henry781/floppy-revival/hardware/fabrication/bom.csv

Reference | Value | QUANTITY | Description | Footprint
A1 | RaspberryPi_Pico2 | 1 | Raspberry Pi Pico 2 (RP2350), soldered flat by its castellations | Module:RaspberryPi_Pico_Common_SMD
C1 | 100nF | 1 | 100nF X7R ceramic, 2.5 mm, Murata RCER71H104K0DBH03A; at U1 VCC (pin 14) | Capacitor_THT:C_Disc_D3.0mm_W1.6mm_P2.50mm
C2 | 100nF | 1 | 100nF X7R ceramic, 2.5 mm, Murata RCER71H104K0DBH03A; at U2 VCC (pin 14) | Capacitor_THT:C_Disc_D3.0mm_W1.6mm_P2.50mm
C3 | 100nF | 1 | 100nF X7R ceramic, 2.5 mm, Murata RCER71H104K0DBH03A; at the Pico 3V3(OUT) | Capacitor_THT:C_Disc_D3.0mm_W1.6mm_P2.50mm
C4 | 47µF | 1 | 47uF 25V electrolytic, Panasonic FR EEUFR1E470 (D5x11, P2.0); 3.3V rail (polarized: pad 1 = +) | Capacitor_THT:CP_Radial_D5.0mm_P2.00mm
C5 | 47µF | 1 | 47uF 25V electrolytic, Panasonic FR EEUFR1E470 (D5x11, P2.0); VBUS at the Pico (polarized: pad 1 = +), total VBUS capacitance kept under ~100uF | Capacitor_THT:CP_Radial_D5.0mm_P2.00mm
C6 | 220uF 25V | 1 | post-filter cap, Panasonic FR EEUFR1E221 (D8x11.5, 3.5mm), at the drive terminal | Capacitor_THT:CP_Radial_D8.0mm_P3.50mm
C7 | 220uF 16V | 1 | post-filter cap, Panasonic FR EEUFR1C221 (D6.3x11.2, 2.5mm), at the drive terminal | Capacitor_THT:CP_Radial_D6.3mm_P2.50mm
C8 | 100uF 35V | 1 | 100uF 35V low-ESR 105C electrolytic, Panasonic FC EEUFC1V101 (D8x11.5, P3.5); switched-node bulk, first cap of the input pi filter | Capacitor_THT:CP_Radial_D8.0mm_P3.50mm
C9,C10 | 100nF | 2 | rail HF decoupling at J5; Murata RDER71H104K0K1H03B (5 mm pitch) | Capacitor_THT:C_Disc_D5.1mm_W3.2mm_P5.00mm
C11 | 10uF 50V | 1 | Q1 gate-source, TDK FG20X7R1H106KRT06 (10uF 50V X7R, 5 mm): ~10 x C22 so an adapter hot-plug cannot couple Q1 on through C22 | Capacitor_THT:C_Disc_D6.0mm_W4.4mm_P5.00mm
C12,C16 | 470uF 35V | 2 | buck input bulk, Panasonic FR EEUFR1V471L (D8x20, 3.5mm, 1.56A ripple), right at VIN/GND | Capacitor_THT:CP_Radial_D8.0mm_P3.50mm
C13,C17 | 1uF 50V | 2 | X7R high-frequency input bypass, closest to VIN pin 2; Murata RDER71H105K2K1H03B | Capacitor_THT:C_Disc_D5.1mm_W3.2mm_P5.00mm
C14,C18 | 10nF 50V | 2 | bootstrap capacitor CB-SW (datasheet: 0.01 uF); Murata RDER71H103K0K1H03B (5 mm pitch) | Capacitor_THT:C_Disc_D5.1mm_W3.2mm_P5.00mm
C15 | 470uF 35V | 1 | buck output cap, Panasonic FR EEUFR1V471L (D8x20, 3.5mm, 30mOhm, same part as the input caps); ESR sets loop stability (datasheet 7.1.3) | Capacitor_THT:CP_Radial_D8.0mm_P3.50mm
C19 | 470uF 16V | 1 | buck output cap, Panasonic FR EEUFR1C471 (D8x11.5, 3.5mm, 56mOhm); ESR sets loop stability (datasheet 7.1.3) | Capacitor_THT:CP_Radial_D8.0mm_P3.50mm
C20 | 470pF 100V | 1 | SW snubber capacitor 470pF 100V C0G, Murata RDE5C2A471J0M1H03A (5 mm pitch), REQUIRED (with R27) | Capacitor_THT:C_Disc_D5.1mm_W3.2mm_P5.00mm
C21 | 470pF 100V | 1 | SW snubber capacitor 470pF 100V C0G, Murata RDE5C2A471J0M1H03A (5 mm pitch), REQUIRED (with R28) | Capacitor_THT:C_Disc_D5.1mm_W3.2mm_P5.00mm
C22 | 1uF 50V | 1 | Q1 Miller capacitor gate-drain, Murata RDER71H105K2K1H03B (1uF 50V X7R, 5 mm): dV/dt ~1 V/ms, adapter peak ~1.9A into the ~1 mF behind Q1 (simulated) | Capacitor_THT:C_Disc_D5.1mm_W3.2mm_P5.00mm
C23 | 10nF 50V | 1 | DRV_EN filter at the ON/OFF pins, Murata RDER71H103K0K1H03B (5 mm pitch) | Capacitor_THT:C_Disc_D5.1mm_W3.2mm_P5.00mm
C24 | 100nF | 1 | adapter sense filter at GP26 (tau 3.5 ms with R31||R32); Murata RDER71H104K0K1H03B (5 mm pitch) | Capacitor_THT:C_Disc_D5.1mm_W3.2mm_P5.00mm
D1 | LED | 1 | LED 3 mm green (ACT), horizontal mount | LED_THT:LED_D3.0mm_Horizontal_O6.35mm_Z6.0mm
D2 | LED | 1 | LED 3 mm red (DIRTY), horizontal mount | LED_THT:LED_D3.0mm_Horizontal_O6.35mm_Z6.0mm
D3 | P6KE27A | 1 | TVS Littelfuse P6KE27A (standoff 23.1V: margin for 20V adapters), input surge clamp | Diode_THT:D_DO-15_P10.16mm_Horizontal
D4 | P6KE15A | 1 | 12V rail TVS, Littelfuse P6KE15A: a shorted regulator switch would put 19.5V on the drive | Diode_THT:D_DO-15_P10.16mm_Horizontal
D5 | P6KE6.8A | 1 | 5V rail TVS, Littelfuse P6KE6.8A: a shorted regulator switch would put 19.5V on the drive logic | Diode_THT:D_DO-15_P10.16mm_Horizontal
D6,D7 | SB560 | 2 | catch diode, Vishay SB560-E3/54 (60V 5A Schottky): simulated reverse peak <= 35V with the snubber | Diode_THT:D_DO-201AD_P5.08mm_Vertical_AnodeUp
F1 | MF-R300 3A 30V | 1 | Resettable PTC fuse, 3A hold / 6A trip, 30V max (MF-RG is only 16V!) | FloppyRevival:PTC_Radial_P5.08mm
J1 | Conn_02x17_Odd_Even | 1 | 34-pin (2x17) box header, 2.54 mm, vertical, keyed | Connector_IDC:IDC-Header_2x17_P2.54mm_Vertical
J2 | Conn_01x03 | 1 | 1x3 pin header 2.54 mm (UART: GND, TX, RX) | Connector_PinHeader_2.54mm:PinHeader_1x03_P2.54mm_Vertical
J3 | Conn_01x02 | 1 | 1x2 pin header 2.54 mm + jumper (read-only) | Connector_PinHeader_2.54mm:PinHeader_1x02_P2.54mm_Vertical
J4 | 19V5 IN | 1 | Phoenix Contact MKDS 1,5/2-5,08 (1715721), 19.5V DC input (pin 1 = +, pin 2 = GND) | TerminalBlock_Phoenix:TerminalBlock_Phoenix_MKDS-1,5-2-5.08_1x02_P5.08mm_Horizontal
J5 | DRIVE PWR | 1 | Phoenix Contact MKDS 1,5/4-5,08 (1715747) to the drive Molex: 1=+12V 2=GND 3=GND 4=+5V | TerminalBlock_Phoenix:TerminalBlock_Phoenix_MKDS-1,5-4-5.08_1x04_P5.08mm_Horizontal
L1,L3 | 33uH 6A | 2 | buck inductor, Feryster DTMSS-16/0.033/6.0-V sendust toroid (33uH at 0A, 23uH at 6A, 24.5mOhm) | FloppyRevival:L_Toroid_Vertical_D22.0mm_W11.0mm_P9.00mm
L2,L4 | 4.7uH 5A | 2 | post-filter inductor, Ferrocore COIL0608-0.0047 (4.7uH, Isat 5A, 22.9mOhm) | FloppyRevival:L_Radial_D7.5mm_P3.00mm
L5 | 4.7uH 5A | 1 | input filter inductor, Ferrocore COIL0608-0.0047: with C8 and the bulk caps a pi filter keeping the 260 kHz input current off the adapter cable (Z0 ~0.07 ohm << converter input ~16 ohm, no Middlebrook issue) | FloppyRevival:L_Radial_D7.5mm_P3.00mm
Q1 | IRF9540N | 1 | P-MOSFET high-side switch, Infineon IRF9540NPBF (-100V, 23A, TO-220 G-D-S) | Package_TO_SOT_THT:TO-220-3_Vertical
Q2 | BC547 | 1 | NPN level shifter GP18 -> Q1 gate, BC547B (TO-92 C-B-E, outer legs bent to 2.54 mm) | Package_TO_SOT_THT:TO-92_Inline_Wide
R9-R13,R19,R20 | 330 | 7 | metal film 0.25W 1%, axial | Resistor_THT:R_Axial_DIN0207_L6.3mm_D2.5mm_P10.16mm_Horizontal
R14 | 1K | 1 | metal film 0.25W 1%, axial | Resistor_THT:R_Axial_DIN0207_L6.3mm_D2.5mm_P10.16mm_Horizontal
R22 | 10k | 1 | Q2 base series resistor; metal film 0.25W 1%, axial | Resistor_THT:R_Axial_DIN0207_L6.3mm_D2.5mm_P10.16mm_Horizontal
R23 | 100k | 1 | Q2 base pull-down: drive power stays OFF while GP18 floats (reset/boot/BOOTSEL); metal film 0.25W 1%, axial | Resistor_THT:R_Axial_DIN0207_L6.3mm_D2.5mm_P10.16mm_Horizontal
R24 | 47k | 1 | Q1 gate-source pull-up (switch OFF by default); metal film 0.25W 1%, axial | Resistor_THT:R_Axial_DIN0207_L6.3mm_D2.5mm_P10.16mm_Horizontal
R25 | 22k | 1 | Q1 gate divider: Vgs = -19.5V x 47/(47+22) = -13V (|Vgs| < 20V max); metal film 0.25W 1%, axial | Resistor_THT:R_Axial_DIN0207_L6.3mm_D2.5mm_P10.16mm_Horizontal
R26 | 2k2 | 1 | Bleed on the switched 19.5V node, Vishay MRS25 2k2 0.6W (173 mW): the ~1 mF behind Q1 is below the regulators' 7.9V lockout 2.6 s after GP18 drops (simulated), inside the firmware's 3.5 s hold | Resistor_THT:R_Axial_DIN0207_L6.3mm_D2.5mm_P10.16mm_Horizontal
R27,R28 | 10R | 2 | SW snubber resistor 10R 1/4W (~25 mW), REQUIRED: without it the catch diode sees up to 40V (simulated) | Resistor_THT:R_Axial_DIN0207_L6.3mm_D2.5mm_P10.16mm_Horizontal
R29 | 1k | 1 | GP18 -> regulator ON/OFF pins (DRV_EN); metal film 0.25W 1%, axial | Resistor_THT:R_Axial_DIN0207_L6.3mm_D2.5mm_P10.16mm_Horizontal
R30 | 4k7 | 1 | DRV_EN pull-down: < 0.43V against the 2 x 45uA ON/OFF pull-ups while GP18 floats; metal film 0.25W 1%, axial | Resistor_THT:R_Axial_DIN0207_L6.3mm_D2.5mm_P10.16mm_Horizontal
R31 | 330k | 1 | adapter sense divider top, 19V5_F -> GP26; metal film 0.25W 1%, axial (57 uA into an unpowered Pico pad) | Resistor_THT:R_Axial_DIN0207_L6.3mm_D2.5mm_P7.62mm_Horizontal
R32 | 39k | 1 | adapter sense divider bottom (ratio 9.46 with R31); metal film 0.25W 1%, axial | Resistor_THT:R_Axial_DIN0207_L6.3mm_D2.5mm_P7.62mm_Horizontal
R33 | 470R | 1 | 5V minimum-load bleeder (10.6 mA, 53 mW): without it U4 leakage lifts the unloaded 5V rail to ~6.1V (bench 2026-11-03) | Resistor_THT:R_Axial_DIN0207_L6.3mm_D2.5mm_P10.16mm_Horizontal
RN1 | 10k x9 | 1 | 10k pull-ups to 3V3 on GP2..GP9, bussed SIP10, Bourns 4610X-101-103LF (pin 1 common) | Resistor_THT:R_Array_SIP10
RN2 | 10k x4 | 1 | 10k pull-ups to 3V3 on GP13..GP10 (7407 inputs), bussed SIP5, Bourns 4605X-101-103LF | Resistor_THT:R_Array_SIP5
RN3 | 1k x4 | 1 | 1k pull-ups to 3V3 on the drive outputs (drive side of the 330s), bussed SIP5, Bourns 4605X-101-102LF | Resistor_THT:R_Array_SIP5
TP1 | WGATE | 1 | test point | TestPoint:TestPoint_THTPad_D2.0mm_Drill1.0mm
TP2 | MOTOR | 1 | test point | TestPoint:TestPoint_THTPad_D2.0mm_Drill1.0mm
TP3 | RDATA | 1 | test point | TestPoint:TestPoint_THTPad_D2.0mm_Drill1.0mm
TP4 | INDEX | 1 | test point | TestPoint:TestPoint_THTPad_D2.0mm_Drill1.0mm
TP5 | +3.3V | 1 | test point | TestPoint:TestPoint_THTPad_D2.0mm_Drill1.0mm
TP6 | VBUS | 1 | test point | TestPoint:TestPoint_THTPad_D2.0mm_Drill1.0mm
TP7,TP8 | GND | 2 | test point | TestPoint:TestPoint_THTPad_D2.0mm_Drill1.0mm
TP9 | RUN | 1 | test point | TestPoint:TestPoint_THTPad_D2.0mm_Drill1.0mm
U1,U2 | 7407 | 2 | TI SN7407N hex open-collector buffer (DIP-14) in a DIP-14 socket, 7.62 mm; outputs STEP, MOTOR, DS1, REDWC, DIR. Non-inverting ONLY (never 7406/74LS06) | Package_DIP:DIP-14_W7.62mm
U1 | 7407 | 1 | TI SN7407N hex open-collector buffer (DIP-14) in a DIP-14 socket, 7.62 mm; outputs SIDE1, WGATE, WDATA. Non-inverting ONLY (never 7406/74LS06) | Package_DIP:DIP-14_W7.62mm
U3 | LM2678T-12 | 1 | 12V 5A buck (ICL min 5.75A, ICL/2 > 1.0A drive peak), 260kHz fixed PWM | Package_TO_SOT_THT:TO-220-7_P2.54x5.08mm_StaggerOdd_Lead3.08mm_Vertical
U4 | LM2676T-5.0 | 1 | 5V 3A buck, 260kHz fixed PWM | Package_TO_SOT_THT:TO-220-7_P2.54x5.08mm_StaggerOdd_Lead3.08mm_Vertical
