henry781/floppy-revival/hardware/simulation/results_light.md

Fixed regulators, VIN 19.5V, constant load, window 100-120 ms (run_light.py)

| Rail | Load (A) | ripple J5 (mVpp) | ripple Cout (mVpp) | V(J5) 100-120 ms | V(J5) 80-90 ms |
|---|---|---|---|---|---|
| 12V | 0.02 | 0.27 | 8.1 | 11.9748 | 11.9748 |
| 12V | 0.04 | 0.86 | 10.7 | 11.9663 | 11.9663 |
| 12V | 0.1 | 1.24 | 14.6 | 11.9561 | 11.9561 |
| 5V | 0.05 | 0.31 | 15.4 | 4.9795 | 4.9795 |
| 5V | 0.2 | 0.47 | 27.5 | 4.9618 | 4.9618 |
