henry781/floppy-revival/hardware/simulation/results_loop.md

Averaged loop gain, LM267x-ADJ rails (run_loop.py)

| case | Vout | fc (kHz) | PM (deg) | f(-180) (kHz) | GM (dB) | min phase below fc |
|---|---|---|---|---|---|---|
| 12V without C_FF (first proposal) | 1.1946 | 3.31 | 33.01 | - | - | -162.92 |
| 12V without C_FF, ESR 10m | 1.1946 | 3.33 | 25.42 | - | - | -168.52 |
| 12V C_FF 2.2n, nominal 1A | 1.1946 | 3.45 | 56.11 | - | - | -151.62 |
| 12V C_FF 2.2n, 0.3A | 1.1947 | 3.46 | 56.24 | - | - | -151.70 |
| 12V C_FF 2.2n, 2.9A | 1.1945 | 3.43 | 55.74 | - | - | -151.41 |
| 12V C_FF 2.2n, VIN 18 | 1.1955 | 3.60 | 59.73 | - | - | -150.45 |
| 12V C_FF 2.2n, VIN 21 | 1.1945 | 3.45 | 55.74 | - | - | -152.65 |
| 12V C_FF 2.2n, ESR 10m (polymer) | 1.1946 | 3.48 | 48.50 | - | - | -157.07 |
| 12V C_FF 2.2n, 2x470uF / 15m | 1.1946 | 2.65 | 34.65 | - | - | -162.16 |
| 12V C_FF 2.2n, ESR 90m (cold x3) | 1.1946 | 3.65 | 79.19 | - | - | -136.60 |
| 12V C_FF 2.2n, ESR 300m (cold x10), post 0.8 | 1.1946 | 255.69 | 54.46 | - | - | -125.22 |
| 12V C_FF 2.2n, GM1 -30%, ESR 10m | 1.1905 | 2.90 | 37.80 | - | - | -157.14 |
| 12V C_FF 2.2n, GM1 +30% | 1.1968 | 4.03 | 68.52 | - | - | -151.58 |
| 12V C_FF 2.2n, -20% C, ESR 90m | 1.1946 | 3.84 | 81.11 | - | - | -137.38 |
| 12V C_FF 4.7n, ESR 300m (cold x10) | 1.1946 | 260.88 | 45.60 | - | - | -134.26 |
| 5V nominal 0.42A (4.02k/1.28k) | 5.0072 | 7.25 | 82.88 | - | - | -158.98 |
| 5V 2A | 5.0069 | 7.15 | 82.39 | - | - | -158.82 |
| 5V ESR 10m | 5.0072 | 6.32 | 39.27 | - | - | -171.96 |
| 5V ESR 280m (cold x5) | 5.0072 | 92.43 | 86.47 | - | - | -97.88 |
| 5V GM1 -30% | 4.9970 | 5.02 | 65.75 | - | - | -159.02 |
| 5V GM1 +50% | 5.0149 | 11.89 | 98.27 | - | - | -158.92 |
