henry781/floppy-revival/hardware/simulation/results_off.md

Switch-off at 300 ms, times after GP18 low (run_off.py)

| R26 | Q1 off (Vgs > -3V) | 12V < 1V | 5V < 0.5V | bus at +1 s | bus at +3 s | bus < 7.9V (UVLO) | bus < 5V |
|---|---|---|---|---|---|---|---|
| 4.7k | 0.68 s | 0.00 s | 0.00 s | 17.78 V | 11.83 V | 4.99 s | - |
| 2.2k | 0.69 s | 0.00 s | 0.00 s | 15.99 V | 6.70 V | 2.62 s | 3.68 s |
