henry781/floppy-revival/hardware/simulation/results_rails.md

| Rail | Case | V(J5) idle | ripple J5 idle (mVpp) | ripple Cout (mVpp) | min V(J5) after step | V(J5) loaded | ripple J5 loaded (mVpp) | max V(J5) on release | I(L) peak start-up (A) | I(L) peak loaded (A) | max V(J5) start-up |
|---|---|---|---|---|---|---|---|---|---|---|---|
| 12V | VIN 18V, idle 0.22A -> spindle 1.0A | 11.944 | 0.72 | 17.4 | 11.839 | 11.902 | 0.76 | 12.007 | 7.10 | 1.57 | 12.603 |
| 12V | VIN 19.5V, idle 0.22A -> spindle 1.0A | 11.939 | 0.20 | 18.3 | 11.831 | 11.897 | 0.89 | 12.002 | 7.10 | 1.64 | 12.694 |
| 12V | VIN 21V, idle 0.22A -> spindle 1.0A | 11.942 | 0.61 | 19.6 | 11.797 | 11.895 | 0.25 | 12.001 | 7.10 | 1.75 | 12.735 |
| 12V | VIN 19.5V, idle 0.22A -> design margin 2.9A | 11.939 | 0.20 | 18.3 | 11.574 | 11.796 | 0.60 | 12.158 | 7.10 | 4.40 | 12.694 |
| 12V | VIN 19.5V, light 0.05A -> 0.22A | 11.951 | 95.15 | 105.3 | 11.852 | 11.939 | 0.76 | 12.044 | 7.10 | 0.79 | 12.694 |
| 5V | VIN 18V, 0.38A -> peak 0.46A | 4.955 | 0.64 | 28.0 | 4.943 | 4.950 | 0.88 | 4.962 | 4.63 | 0.71 | 5.512 |
| 5V | VIN 19.5V, 0.38A -> peak 0.46A | 4.952 | 1.30 | 29.6 | 4.941 | 4.947 | 0.70 | 4.959 | 4.63 | 0.72 | 5.536 |
| 5V | VIN 21V, 0.38A -> peak 0.46A | 4.951 | 1.48 | 30.7 | 4.939 | 4.947 | 1.26 | 4.958 | 4.63 | 0.73 | 5.562 |
| 5V | VIN 19.5V, 0.38A -> design margin 2.0A | 4.952 | 1.30 | 29.6 | 4.729 | 4.865 | 1.27 | 5.088 | 4.63 | 2.81 | 5.536 |
| 5V | VIN 19.5V, light 0.05A -> 0.38A | 4.979 | 15.24 | 28.2 | 4.857 | 4.952 | 1.02 | 5.027 | 4.63 | 0.94 | 5.536 |
