henry781/floppy-revival/hardware/simulation/results_chain.md

### Switch-on: adapter present, GP18 raised at 5 ms (idle drive)

- iad_pk = 1.861397e+00
- t10 = 4.678358e-02
- t90 = 7.744473e-02
- p_q1_pk = 2.081135e+01
- e_q1 = 3.56265e-01
- il1_pk = 1.817561e+00
- il3_pk = 1.213709e+00
- il5_pk = 1.823655e+00
- t12 = 7.143532e-02
- t5 = 6.454591e-02
- v12_end = 1.193940e+01
- v5_end = 4.952300e+00
- v12_max = 1.209953e+01
- v5_max = 5.119432e+00
- vgs_min = -8.941963e+00
- t_on = 3.231281e-02

### Switch-on, X7R DC-bias derated gate caps (C11 6uF, C22 0.7uF)

- iad_pk = 2.444773e+00
- t10 = 2.939986e-02
- t90 = 5.116670e-02
- p_q1_pk = 2.704702e+01
- e_q1 = 3.39629e-01
- il1_pk = 2.398207e+00
- il3_pk = 1.518080e+00
- il5_pk = 2.399839e+00
- t12 = 4.699953e-02
- t5 = 4.206035e-02
- v12_end = 1.193939e+01
- v5_end = 4.952307e+00
- v12_max = 1.211986e+01
- v5_max = 5.140344e+00
- vgs_min = -1.120971e+01
- t_on = 1.945790e-02

### Switch-off: GP18 driven low at 300 ms after a normal start

- id_q1_after = 0.000000e+00

### Hot-plug: adapter plugged at 1 ms with GP18 low (Q1 must stay off)

- vgs_plug_min = -2.658077e+00
- il5_plug = 8.836770e-01
- vsw_plug = 1.947025e+00
- vj4_pk = 2.991322e+01
- vf_pk = 2.960888e+01
- drven_max = 3.298246e-02
- v12_plug = -1.236671e-19
- v5_plug = -7.496979e-20
