henry781/floppy-revival/hardware/simulation/results_inrush.md

### C11 4.7u, C22 470n

- iad_pk = 2.951634e+00
- t_ramp10 = 2.595913e-02
- t_ramp90 = 4.201883e-02
- p_q1_pk = 3.221456e+01
- e_q1 = 3.27671e-01
- t_over_231 = 4.82835e-02
- t_over_334 = 4.82835e-02
- t12 = 3.926582e-02
- v12_max = 1.214187e+01
- v5_max = 5.155108e+00

### C11 10u, C22 1u

- iad_pk = 1.861675e+00
- t_ramp10 = 4.678358e-02
- t_ramp90 = 7.744481e-02
- p_q1_pk = 2.081520e+01
- e_q1 = 3.55981e-01
- t_over_231 = 5.71626e-02
- t_over_334 = 5.71626e-02
- t12 = 7.143182e-02
- v12_max = 1.209852e+01
- v5_max = 5.119401e+00
