henry781/floppy-revival/hardware/simulation/results_swring.md

| hot-loop L (nH) | I(L) (A) | snubber | V(SW) peak (V) | V(SW) min at turn-off (V) | VIN pin peak (V) | diode reverse peak (V) | rise 10-90% (ns) | ringing pp after the edge (V) | snubber loss (W) |
|---|---|---|---|---|---|---|---|---|---|
| 30 | 1 | none | 25.2 | -2.48 | 24.7 | 31.5 | 8.8 | 8.4 | 0.000 |
| 30 | 1 | 10R+470p | 19.5 | -2.31 | 21.6 | 20.0 | 40.3 | 0.0 | 0.013 |
| 30 | 3 | none | 27.0 | -4.35 | 26.6 | 35.9 | 15.1 | 11.4 | 0.000 |
| 30 | 3 | 10R+470p | 19.6 | -4.26 | 22.6 | 22.8 | 53.4 | 0.2 | 0.015 |
| 50 | 1 | none | 28.1 | -3.48 | 25.6 | 38.7 | 12.4 | 12.9 | 0.000 |
| 50 | 1 | 10R+470p | 19.5 | -3.23 | 21.5 | 23.2 | 20.8 | 0.0 | 0.015 |
| 50 | 3 | none | 28.6 | -6.39 | 27.0 | 40.4 | 20.5 | 14.2 | 0.000 |
| 50 | 3 | 10R+470p | 19.6 | -6.23 | 22.2 | 26.5 | 28.8 | 0.2 | 0.020 |
| 70 | 1 | none | 28.5 | -4.31 | 26.0 | 40.4 | 14.3 | 13.9 | 0.000 |
| 70 | 1 | 10R+470p | 19.7 | -4.00 | 21.6 | 25.3 | 23.7 | 0.0 | 0.017 |
| 70 | 3 | none | 28.3 | -8.15 | 26.2 | 40.4 | 26.3 | 14.2 | 0.000 |
| 70 | 3 | 10R+470p | nan | nan | nan | nan | nan | nan | nan |
