henry781/floppy-revival/hardware/simulation/results_swring2.md

| hot-loop L (nH) | I(L) (A) | snubber loop L | diode | V(SW) peak (V) | diode reverse peak (V) | ringing pp (V) | snubber loss (W) |
|---|---|---|---|---|---|---|---|
| 50 | 1 | 25n | SB540-like | nan | nan | nan | nan |
| 50 | 1 | 25n | SB560-like | -0.5 | -0.5 | 0.0 | 0.004 |
| 50 | 1 | 50n | SB540-like | 20.7 | 28.3 | 0.4 | 0.016 |
| 50 | 1 | 50n | SB560-like | 20.8 | 27.9 | 0.4 | 0.015 |
| 50 | 3 | 25n | SB540-like | nan | nan | nan | nan |
| 50 | 3 | 25n | SB560-like | 19.6 | 26.4 | 0.2 | 0.018 |
| 50 | 3 | 50n | SB540-like | 21.9 | 32.6 | 0.6 | 0.020 |
| 50 | 3 | 50n | SB560-like | 21.7 | 32.7 | 0.7 | 0.019 |
| 70 | 1 | 25n | SB540-like | 19.7 | 25.3 | 0.0 | 0.017 |
| 70 | 1 | 25n | SB560-like | 19.6 | 25.1 | 0.0 | 0.016 |
| 70 | 1 | 50n | SB540-like | nan | nan | nan | nan |
| 70 | 1 | 50n | SB560-like | 3.6 | -0.5 | 0.0 | 0.007 |
| 70 | 3 | 25n | SB540-like | 19.8 | 28.3 | 0.2 | 0.024 |
| 70 | 3 | 25n | SB560-like | 19.5 | 28.4 | 0.2 | 0.022 |
| 70 | 3 | 50n | SB540-like | -0.6 | -0.7 | 0.0 | 0.021 |
| 70 | 3 | 50n | SB560-like | 22.2 | 34.7 | 0.6 | 0.023 |
