henry781/floppy-revival/hardware/floppy-revival-schematic.pdf

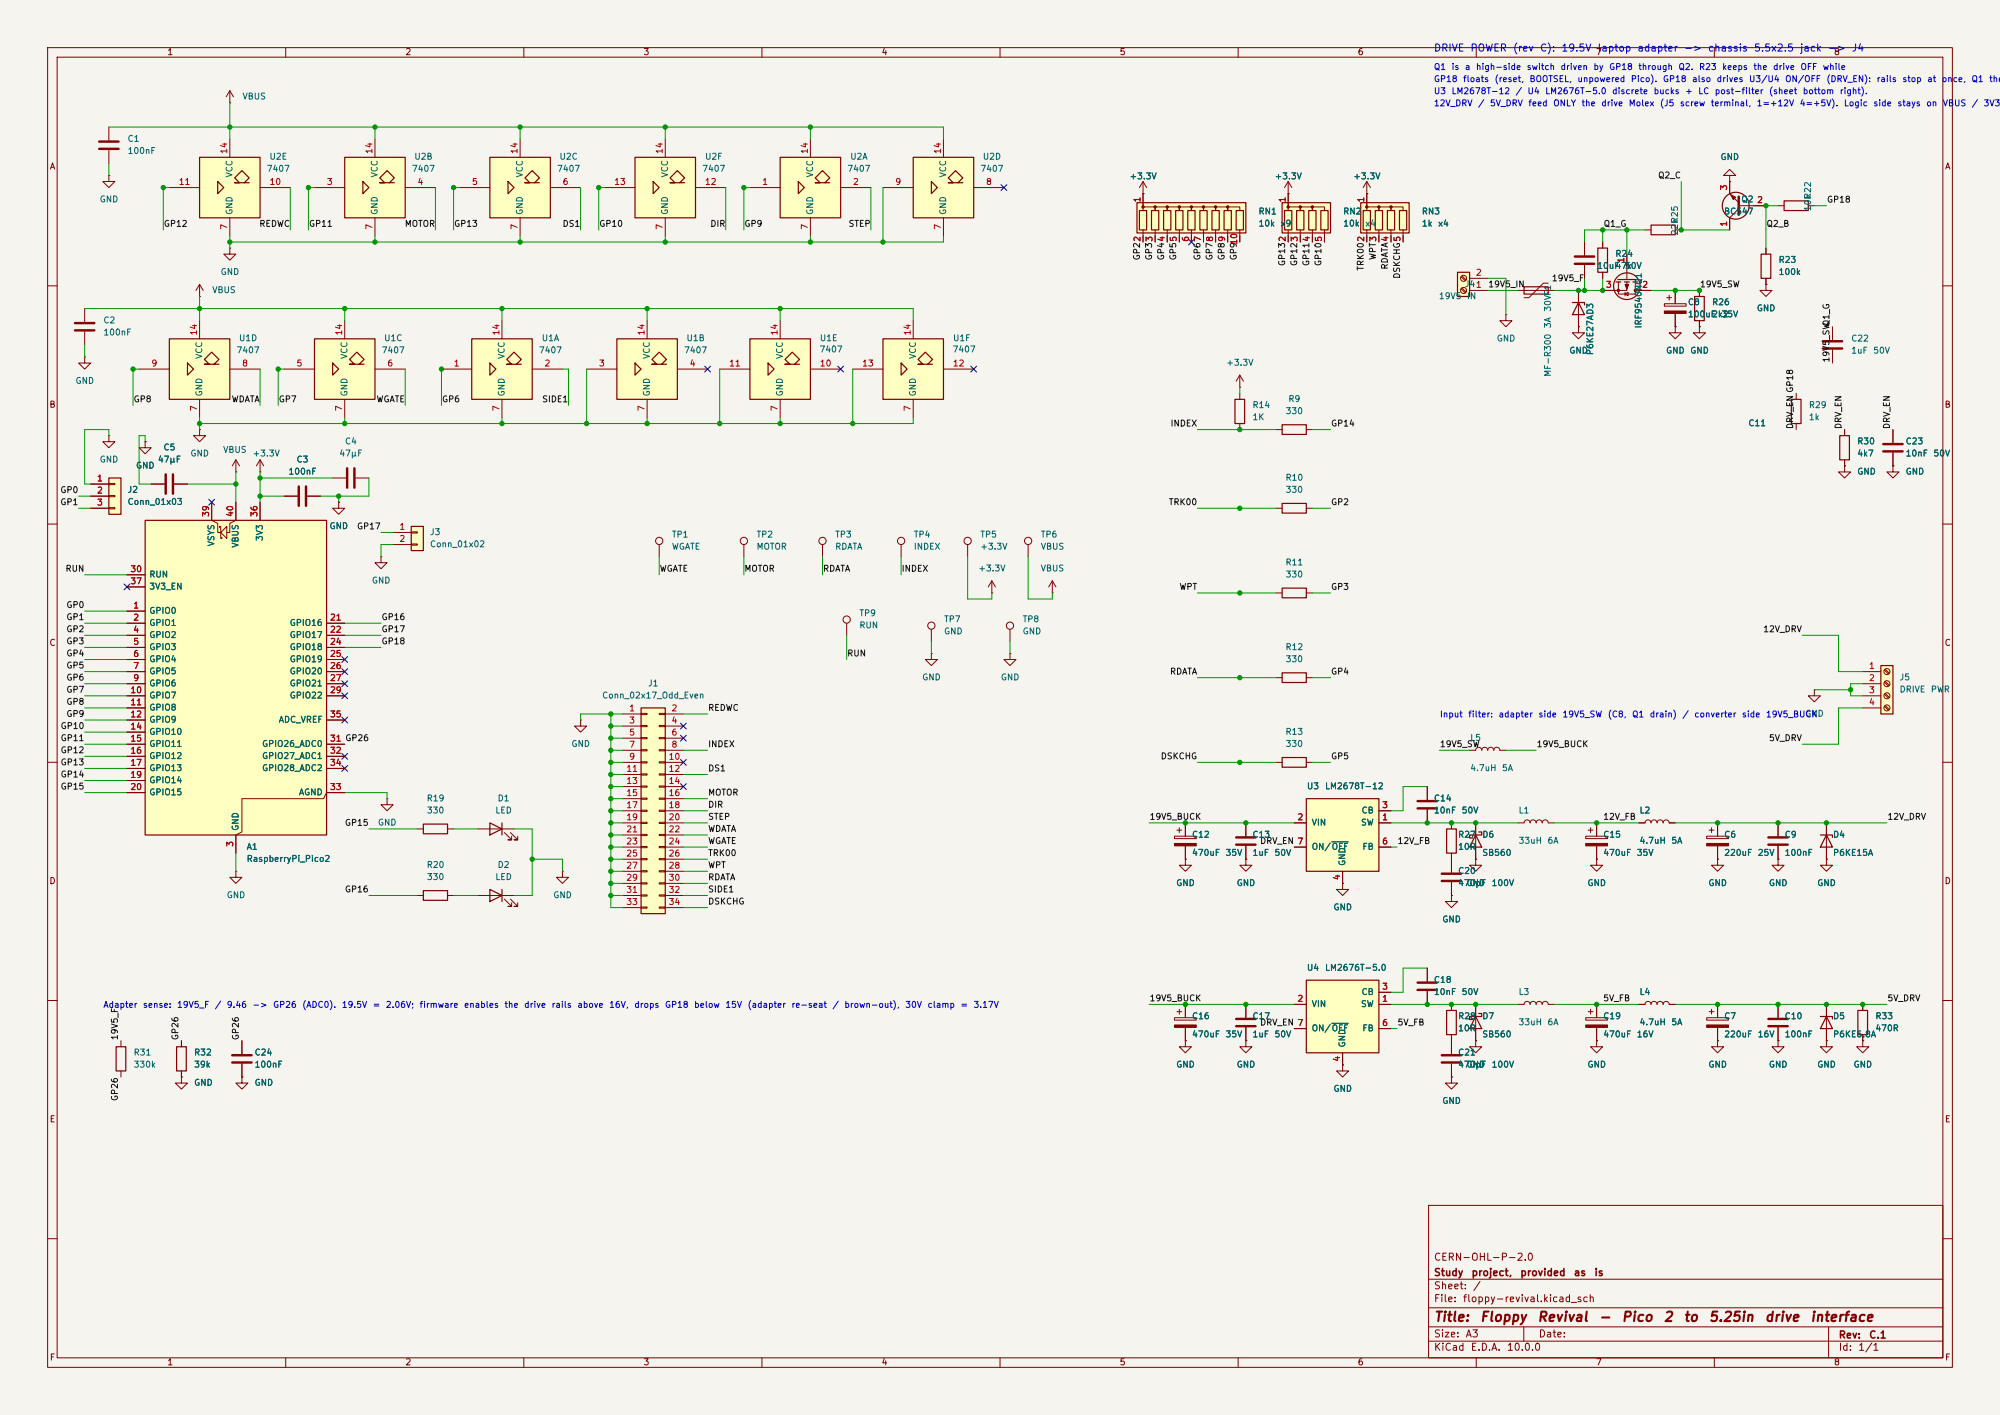
[picture p2: page 1]

DRIVE POWER (rev C): 19.5V laptop adapter -> chassis 5.5x2.5 jack -> J4

Q1 is a high-side switch driven by GP18 through Q2. R23 keeps the drive OFF while GP18 floats (reset, BOOTSEL, unpowered Pico). GP18 also drives U3/U4 ON/OFF (DRV_EN): rails stop at once, Q1 then turns off unloaded. 12V_DRV / 5V_DRV feed ONLY the drive Molex (J5 screw terminal, 1=+12V 4=+5V). Logic side stays on VBUS / 3V3.

U3 LM2678T-12 / U4 LM2676T-5.0 discrete bucks + LC post-filter (sheet bottom right).

RDATA WGATE WDATA DIR
STEP

Input filter: adapter side 19V5_SW (C8, Q1 drain) / converter side 19V5_BUCK

Adapter sense: 19V5_F / 9.46 -> GP26 (ADC0). 19.5V = 2.06V; firmware enables the drive rails above 16V, drops GP18 below 15V (adapter re-seat / brown-out), 30V clamp = 3.17V

Study project, provided as is CERN-OHL-P-2.0

Sheet: /
File: floppy-revival.kicad_sch
Title: Floppy Revival - Pico 2 to 5.25in drive interface

Size: A3 | Rev: C.1 | F Date:
KiCad E.D.A. 10.0.0 | Id: 1/1
