henry781/floppy-revival/hardware/kicad/floppy-revival.kicad_pcb

## KiCad design hardware/kicad/floppy-revival.kicad_pcb (2026-11-06)

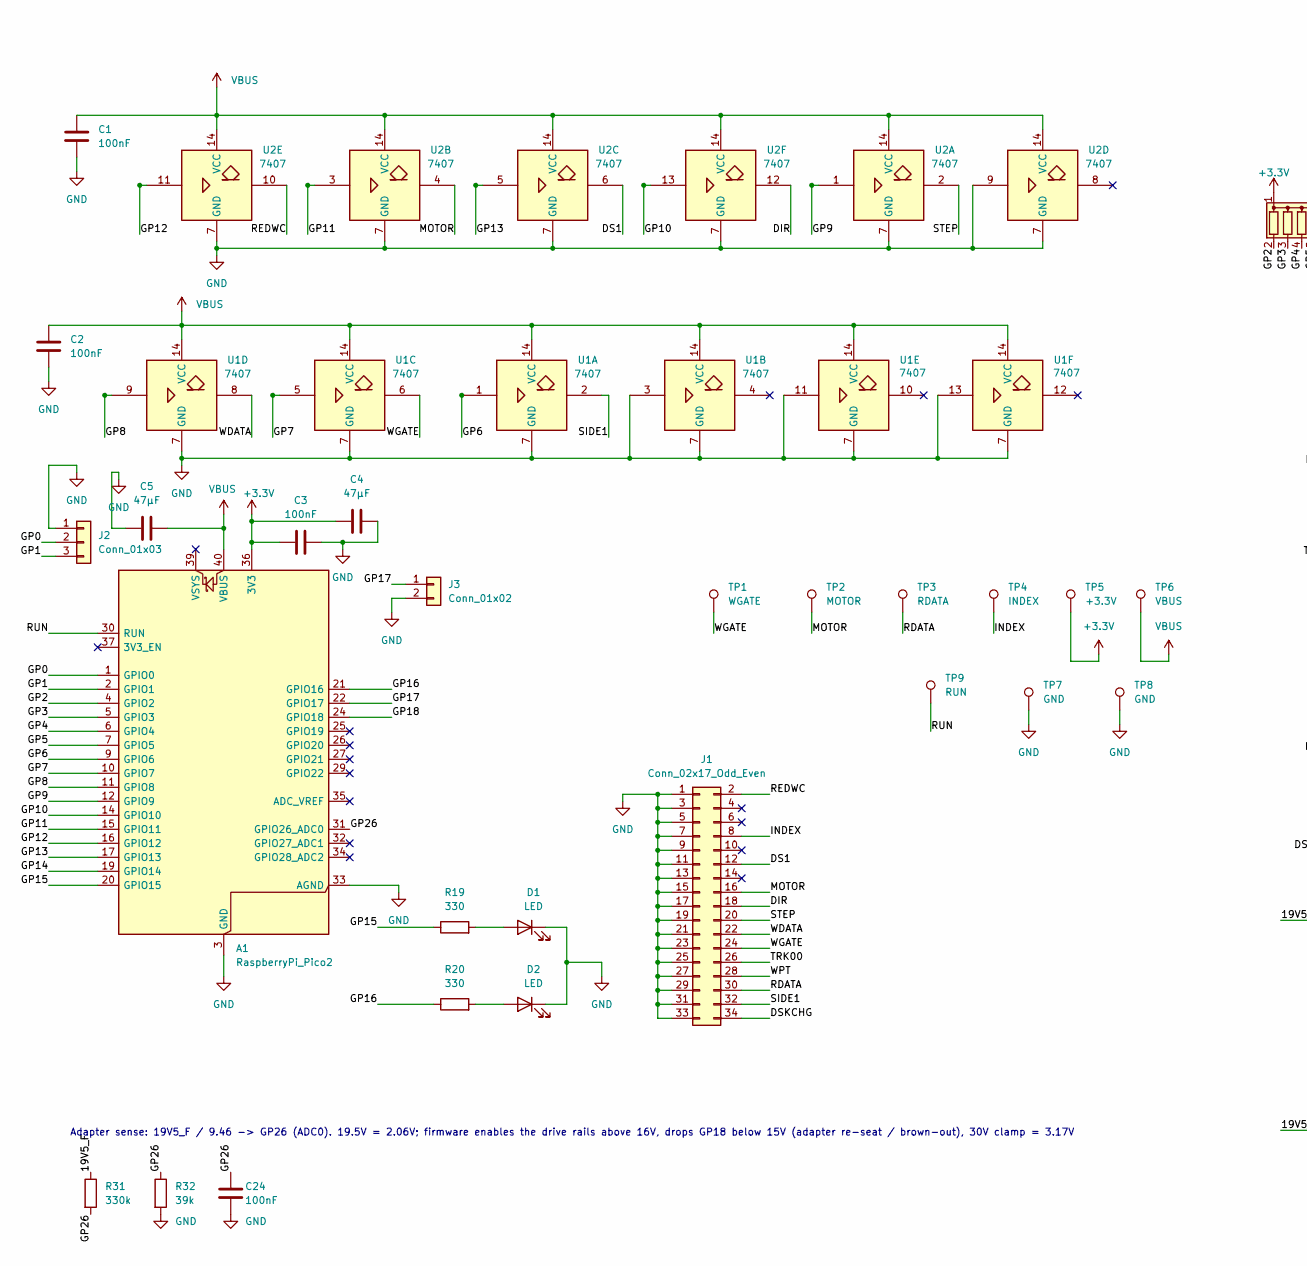
[picture p3: schematic floppy-revival.kicad_sch, Floppy Revival - Pico 2 to 5.25in drive interface, part in row 1, column 1]

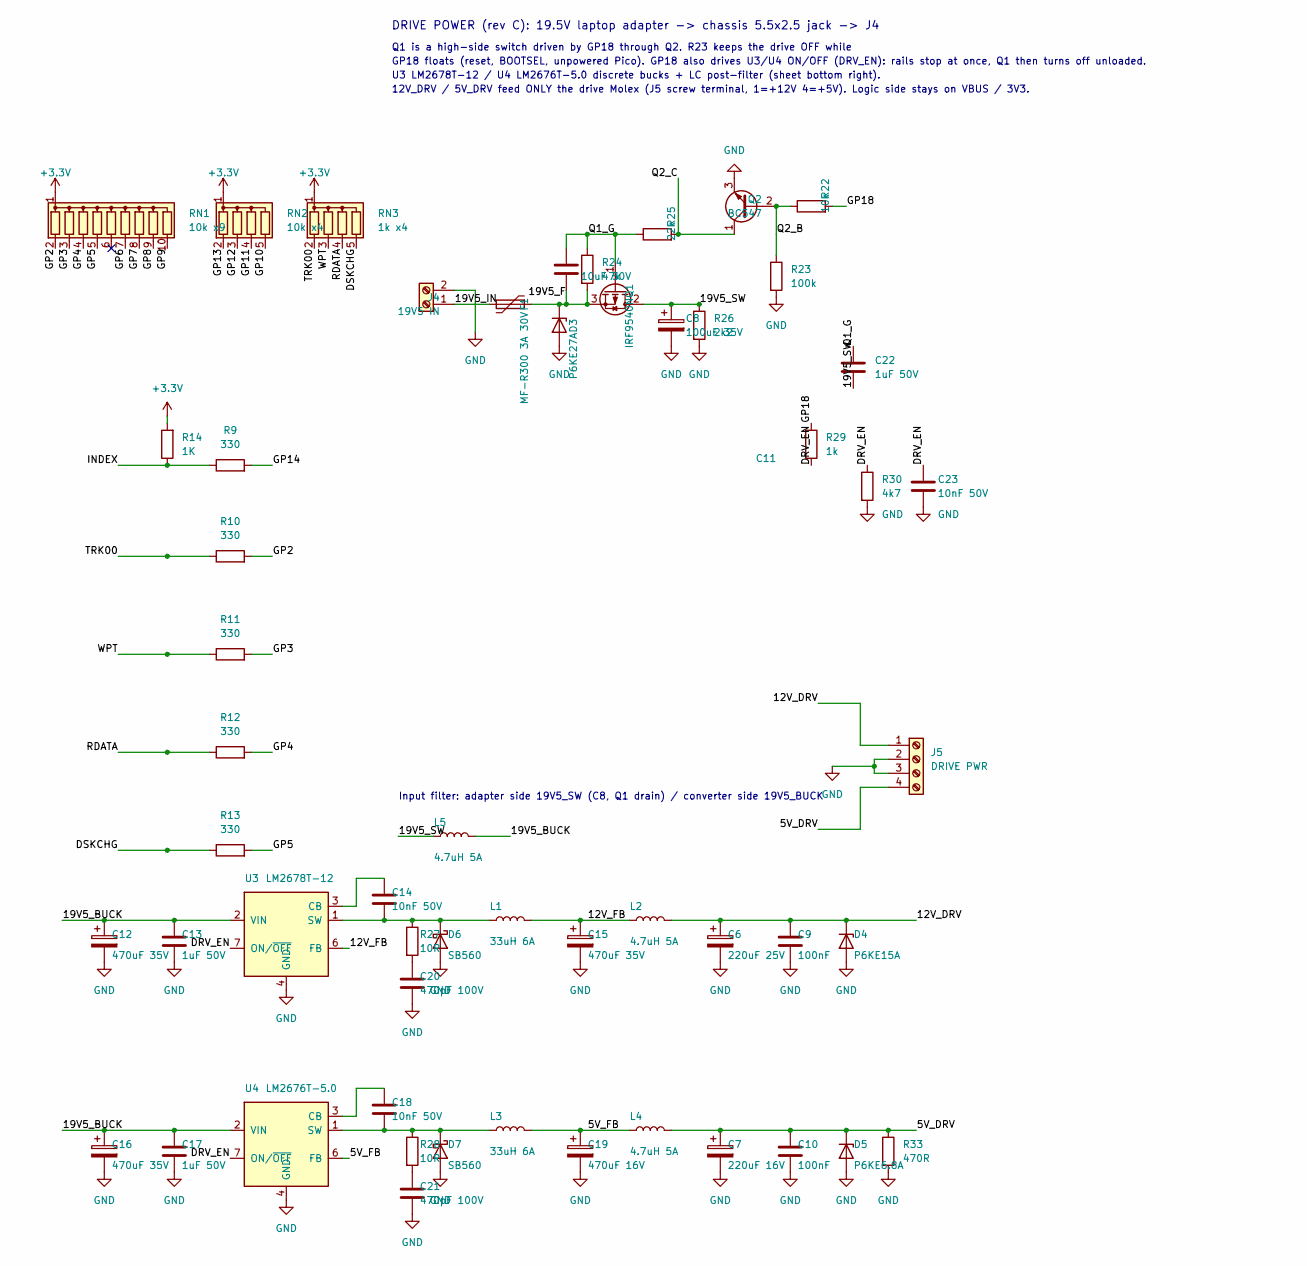
[picture p4: schematic floppy-revival.kicad_sch, Floppy Revival - Pico 2 to 5.25in drive interface, part in row 1, column 2]

Parts:
A1: RaspberryPi_Pico2; RaspberryPi_Pico_Common_SMD
C1, C2, C3: 100nF; C_Disc_D3.0mm_W1.6mm_P2.50mm
C4, C5: 47µF; CP_Radial_D5.0mm_P2.00mm
C6: 220uF 25V; CP_Radial_D8.0mm_P3.50mm
C7: 220uF 16V; CP_Radial_D6.3mm_P2.50mm
C8: 100uF 35V; CP_Radial_D8.0mm_P3.50mm
C9, C10, C24: 100nF; C_Disc_D5.1mm_W3.2mm_P5.00mm
C11: 10uF 50V; C_Disc_D6.0mm_W4.4mm_P5.00mm
C12, C15, C16: 470uF 35V; CP_Radial_D8.0mm_P3.50mm
C13, C17, C22: 1uF 50V; C_Disc_D5.1mm_W3.2mm_P5.00mm
C14, C18, C23: 10nF 50V; C_Disc_D5.1mm_W3.2mm_P5.00mm
C19: 470uF 16V; CP_Radial_D8.0mm_P3.50mm
C20, C21: 470pF 100V; C_Disc_D5.1mm_W3.2mm_P5.00mm
D1, D2: LED; LED_D3.0mm_Horizontal_O6.35mm_Z6.0mm
D3: P6KE27A; D_DO-15_P10.16mm_Horizontal
D4: P6KE15A; D_DO-15_P10.16mm_Horizontal
D5: P6KE6.8A; D_DO-15_P10.16mm_Horizontal
D6, D7: SB560; D_DO-201AD_P5.08mm_Vertical_AnodeUp
F1: MF-R300 3A 30V; PTC_Radial_P5.08mm
J1: Conn_02x17_Odd_Even; IDC-Header_2x17_P2.54mm_Vertical
J2: Conn_01x03; PinHeader_1x03_P2.54mm_Vertical
J3: Conn_01x02; PinHeader_1x02_P2.54mm_Vertical
J4: 19V5 IN; TerminalBlock_Phoenix_MKDS-1,5-2-5.08_1x02_P5.08mm_Horizont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
J5: DRIVE PWR; TerminalBlock_Phoenix_MKDS-1,5-4-5.08_1x04_P5.08mm_Horizont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
L1, L3: 33uH 6A; L_Toroid_Vertical_D22.0mm_W11.0mm_P9.00mm
L2, L4, L5: 4.7uH 5A; L_Radial_D7.5mm_P3.00mm
Q1: IRF9540N; TO-220-3_Vertical
Q2: BC547; TO-92_Inline_Wide
R9, R10, R11, R12, R13, R19, R20: 330; R_Axial_DIN0207_L6.3mm_D2.5mm_P10.16mm_Horizontal
R14: 1K; R_Axial_DIN0207_L6.3mm_D2.5mm_P10.16mm_Horizontal
R22: 10k; R_Axial_DIN0207_L6.3mm_D2.5mm_P10.16mm_Horizontal
R23: 100k; R_Axial_DIN0207_L6.3mm_D2.5mm_P10.16mm_Horizontal
R24: 47k; R_Axial_DIN0207_L6.3mm_D2.5mm_P10.16mm_Horizontal
R25: 22k; R_Axial_DIN0207_L6.3mm_D2.5mm_P10.16mm_Horizontal
R26: 2k2; R_Axial_DIN0207_L6.3mm_D2.5mm_P10.16mm_Horizontal
R27, R28: 10R; R_Axial_DIN0207_L6.3mm_D2.5mm_P10.16mm_Horizontal
R29: 1k; R_Axial_DIN0207_L6.3mm_D2.5mm_P10.16mm_Horizontal
R30: 4k7; R_Axial_DIN0207_L6.3mm_D2.5mm_P10.16mm_Horizontal
R31: 330k; R_Axial_DIN0207_L6.3mm_D2.5mm_P7.62mm_Horizontal
R32: 39k; R_Axial_DIN0207_L6.3mm_D2.5mm_P7.62mm_Horizontal
R33: 470R; R_Axial_DIN0207_L6.3mm_D2.5mm_P10.16mm_Horizontal
RN1: 10k x9; R_Array_SIP10
RN2: 10k x4; R_Array_SIP5
RN3: 1k x4; R_Array_SIP5
TP1: WGATE; TestPoint_THTPad_D2.0mm_Drill1.0mm
TP2: MOTOR; TestPoint_THTPad_D2.0mm_Drill1.0mm
TP3: RDATA; TestPoint_THTPad_D2.0mm_Drill1.0mm
TP4: INDEX; TestPoint_THTPad_D2.0mm_Drill1.0mm
TP5: +3.3V; TestPoint_THTPad_D2.0mm_Drill1.0mm
TP6: VBUS; TestPoint_THTPad_D2.0mm_Drill1.0mm
TP7, TP8: GND; TestPoint_THTPad_D2.0mm_Drill1.0mm
TP9: RUN; TestPoint_THTPad_D2.0mm_Drill1.0mm
U1, U2: 7407; DIP-14_W7.62mm
U3: LM2678T-12; TO-220-7_P2.54x5.08mm_StaggerOdd_Lead3.08mm_Vertical
U4: LM2676T-5.0; TO-220-7_P2.54x5.08mm_StaggerOdd_Lead3.08mm_Vertical

Connections:
+3.3V: A1.36 (3V3), C3.2, C4.1, R14.2, RN1.1 (common), RN2.1 (common), RN3.1 (common), TP5.1 (1_1)
/5V_DRV: C7.1, C10.1, D5.1 (K), J5.4, L4.2, R33.1
/5V_FB: C19.1, L3.2, L4.1, U4.6 (FB)
/12V_DRV: C6.1, C9.1, D4.1 (K), J5.1, L2.2
/12V_FB: C15.1, L1.2, L2.1, U3.6 (FB)
/19V5_BUCK: C12.1, C13.1, C16.1, C17.1, L5.2, U3.2 (VIN), U4.2 (VIN)
/19V5_F: C11.2, D3.1 (K), F1.1, Q1.3 (S), R24.2, R31.1
/19V5_IN: F1.2, J4.1
/19V5_SW: C8.1, C22.2, L5.1, Q1.2 (D), R26.1
/DIR: J1.18, U2.12
/DRV_EN: C23.1, R29.2, R30.1, U3.7 (ON/~OFF), U4.7 (ON/~OFF)
/DS1: J1.12, U2.6
/DSKCHG: J1.34, R13.1, RN3.5 (R4)
/GP0: A1.1 (GPIO0), J2.2
/GP1: A1.2 (GPIO1), J2.3
/GP2: A1.4 (GPIO2), R10.2, RN1.2 (R1)
/GP3: A1.5 (GPIO3), R11.2, RN1.3 (R2)
/GP4: A1.6 (GPIO4), R12.2, RN1.4 (R3)
/GP5: A1.7 (GPIO5), R13.2, RN1.5 (R4)
/GP6: A1.9 (GPIO6), RN1.7 (R6), U1.1
/GP7: A1.10 (GPIO7), RN1.8 (R7), U1.5
/GP8: A1.11 (GPIO8), RN1.9 (R8), U1.9
/GP9: A1.12 (GPIO9), RN1.10 (R9), U2.1
/GP10: A1.14 (GPIO10), RN2.5 (R4), U2.13
/GP11: A1.15 (GPIO11), RN2.4 (R3), U2.3
/GP12: A1.16 (GPIO12), RN2.3 (R2), U2.11
/GP13: A1.17 (GPIO13), RN2.2 (R1), U2.5
/GP14: A1.19 (GPIO14), R9.2
/GP15: A1.20 (GPIO15), R19.1
/GP16: A1.21 (GPIO16), R20.1
/GP17: A1.22 (GPIO17), J3.1
/GP18: A1.24 (GPIO18), R22.2, R29.1
/GP26: A1.31 (GPIO26_ADC0), C24.1, R31.2, R32.1
/INDEX: J1.8, R9.1, R14.1, TP4.1 (1_1)
/MOTOR: J1.16, TP2.1 (1_1), U2.4
/Q1_G: C11.1, C22.1, Q1.1 (G), R24.1, R25.1
/Q2_B: Q2.2 (B), R22.1, R23.1
/Q2_C: Q2.1 (C), R25.2
/RDATA: J1.30, R12.1, RN3.4 (R3), TP3.1 (1_1)
/REDWC: J1.2, U2.10
/RUN: A1.30 (RUN), TP9.1 (1_1)
/SIDE1: J1.32, U1.2
/STEP: J1.20, U2.2
/TRK00: J1.26, R10.1, RN3.2 (R1)
/WDATA: J1.22, U1.8
/WGATE: J1.24, TP1.1 (1_1), U1.6
/WPT: J1.28, R11.1, RN3.3 (R2)
GND: A1.3 (GND), A1.8 (GND), A1.13 (GND), A1.18 (GND), A1.23 (GND), A1.28 (GND), A1.33 (AGND), A1.38 (GND), C1.2, C2.2, C3.1, C4.2, C5.2, C6.2, C7.2, C8.2, C9.2, C10.2, C12.2, C13.2, C15.2, C16.2, C17.2, C19.2, C20.2, C21.2, C23.2, C24.2, D1.1 (K), D2.1 (K), D3.2 (A), D4.2 (A), D5.2 (A), D6.2 (A), D7.2 (A), J1.1, J1.3, J1.5, J1.7, J1.9, J1.11, J1.13, J1.15, J1.17, J1.19, J1.21, J1.23, J1.25, J1.27, J1.29, J1.31, J1.33, J2.1, J3.2, J4.2, J5.2, J5.3, Q2.3 (E), R23.2, R26.2, R30.2, R32.2, R33.2, TP7.1 (1_1), TP8.1 (1_1), U1.3, U1.7 (GND), U1.11, U1.13, U2.7 (GND), U2.9, U3.4 (GND), U4.4 (GND)
unnamed: C20.1, R27.2
unnamed: C21.1, R28.2
unnamed: D1.2 (A), R19.2
unnamed: D2.2 (A), R20.2
unnamed: C14.2, D6.1 (K), L1.1, R27.1, U3.1 (SW)
unnamed: C18.2, D7.1 (K), L3.1, R28.1, U4.1 (SW)
unnamed: C14.1, U3.3 (CB)
unnamed: C18.1, U4.3 (CB)
VBUS: A1.40 (VBUS), C1.1, C2.1, C5.1, TP6.1 (1_1), U1.14 (VCC), U2.14 (VCC)

Notes on the sheet:
DRIVE POWER (rev C): 19.5V laptop adapter -> chassis 5.5x2.5 jack -> J4
Q1 is a high-side switch driven by GP18 through Q2. R23 keeps the drive OFF while
GP18 floats (reset, BOOTSEL, unpowered Pico). GP18 also drives U3/U4 ON/OFF (DRV_EN): rails stop at once, Q1 then turns off unloaded.
U3 LM2678T-12 / U4 LM2676T-5.0 discrete bucks + LC post-filter (sheet bottom right).
12V_DRV / 5V_DRV feed ONLY the drive Molex (J5 screw terminal, 1=+12V 4=+5V). Logic side stays on VBUS / 3V3.
Input filter: adapter side 19V5_SW (C8, Q1 drain) / converter side 19V5_BUCK
Adapter sense: 19V5_F / 9.46 -> GP26 (ADC0). 19.5V = 2.06V; firmware enables the drive rails above 16V, drops GP18 below 15V (adapter re-seat / brown-out), 30V clamp = 3.17V

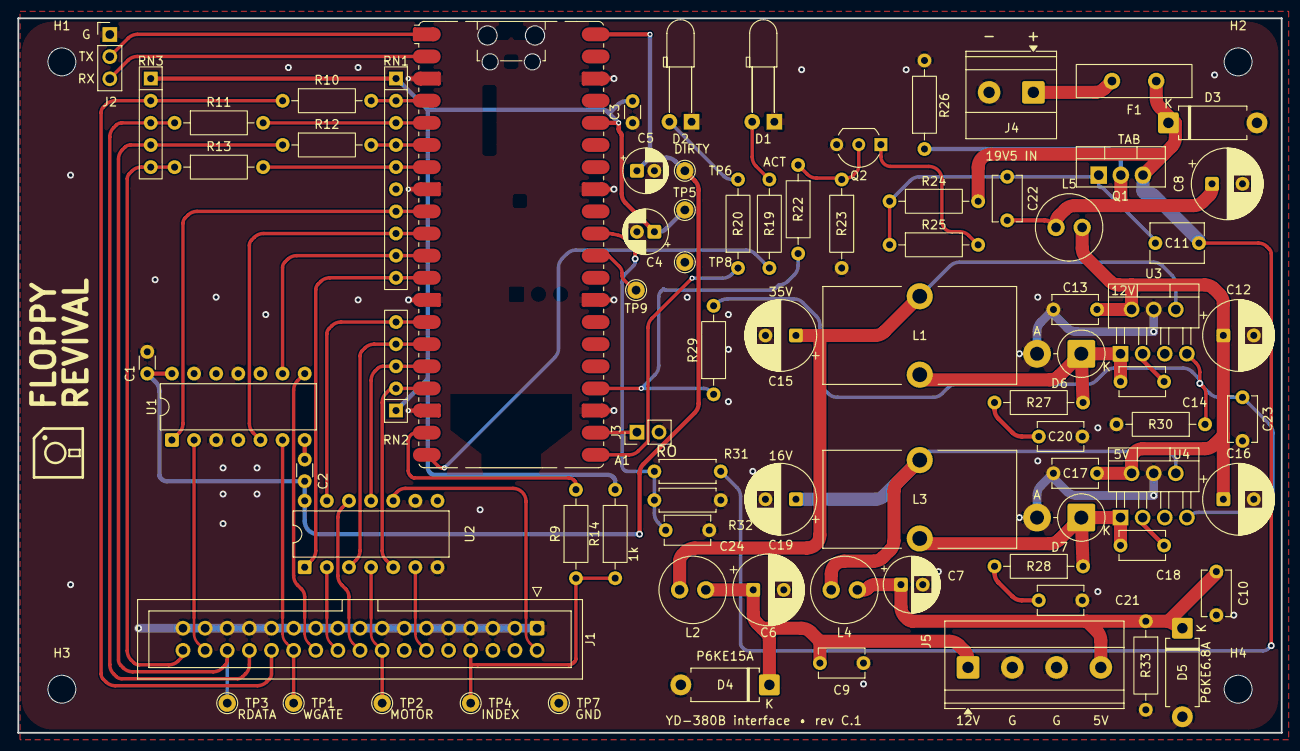
[picture p5: board floppy-revival.kicad_pcb from above]

Board: 2 copper layers, 145.0 x 82.0 mm, 85 parts (0 on the bottom side), 57 nets.

Other parts of the board:
H1, H2, H3, H4: MountingHole_3.2mm_M3
