henry781/floppy-revival/firmware/src/tusb_config.h

#ifndef TUSB_CONFIG_H_
#define TUSB_CONFIG_H_

#ifdef __cplusplus
extern "C" {
#endif

//--------------------------------------------------------------------
// Common configuration
//--------------------------------------------------------------------

#ifndef CFG_TUSB_MCU
#error CFG_TUSB_MCU must be defined (comes from the pico-sdk TinyUSB integration)
#endif

#ifndef CFG_TUSB_OS
#define CFG_TUSB_OS OPT_OS_PICO
#endif

#ifndef CFG_TUSB_DEBUG
#define CFG_TUSB_DEBUG 0
#endif

#define CFG_TUD_ENABLED 1

#ifndef CFG_TUSB_MEM_SECTION
#define CFG_TUSB_MEM_SECTION
#endif

#ifndef CFG_TUSB_MEM_ALIGN
#define CFG_TUSB_MEM_ALIGN __attribute__((aligned(4)))
#endif

//--------------------------------------------------------------------
// Device configuration
//--------------------------------------------------------------------

#define CFG_TUD_ENDPOINT0_SIZE 64

#define CFG_TUD_MSC 1
#define CFG_TUD_CDC 0
#define CFG_TUD_HID 0
#define CFG_TUD_MIDI 0
#define CFG_TUD_VENDOR 0

// One full sector per MSC transfer buffer.
#define CFG_TUD_MSC_EP_BUFSIZE 512

#ifdef __cplusplus
}
#endif

#endif // TUSB_CONFIG_H_
